finnff/mrb2021/img/2023-08-11-15-56-42.png

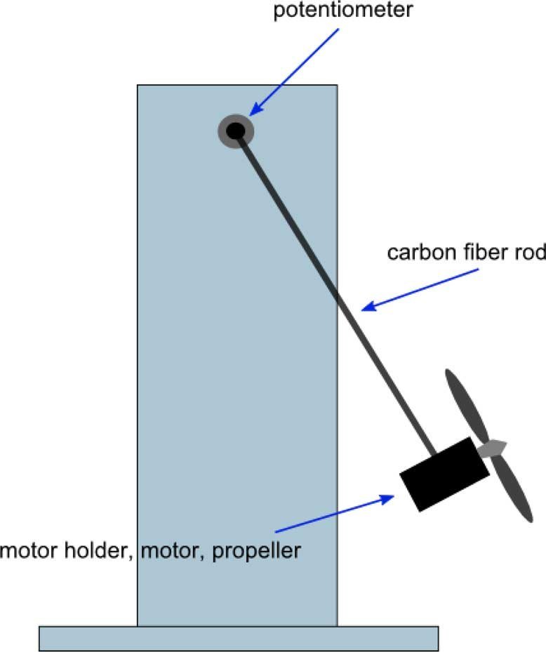
img/2023-08-11-15-56-42.png
