finnff/mrb2021/img/2023-08-28-07-30-38.png

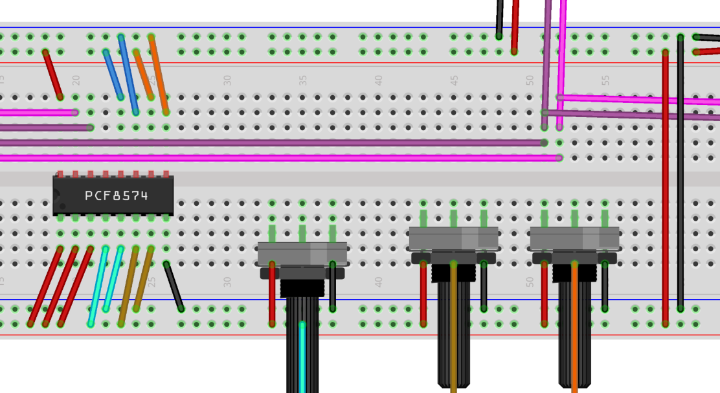
img/2023-08-28-07-30-38.png
