finnff/mrb2021/img/2023-08-28-08-42-56.png

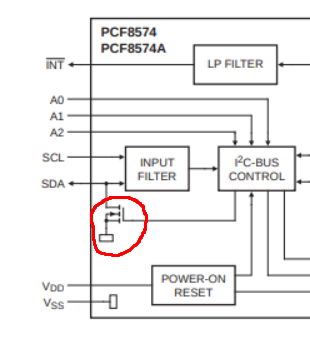
img/2023-08-28-08-42-56.png
