finnff/mrb2021/img/2023-08-28-09-48-56.png

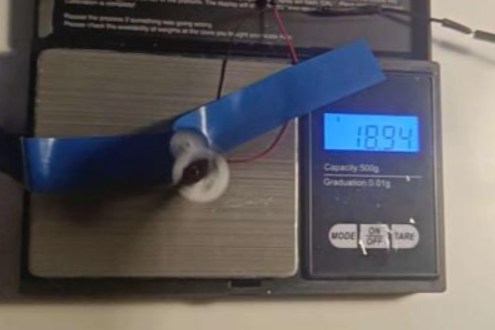
img/2023-08-28-09-48-56.png
