finnff/mrb2021/img/IMG_MRB_1643.jpg

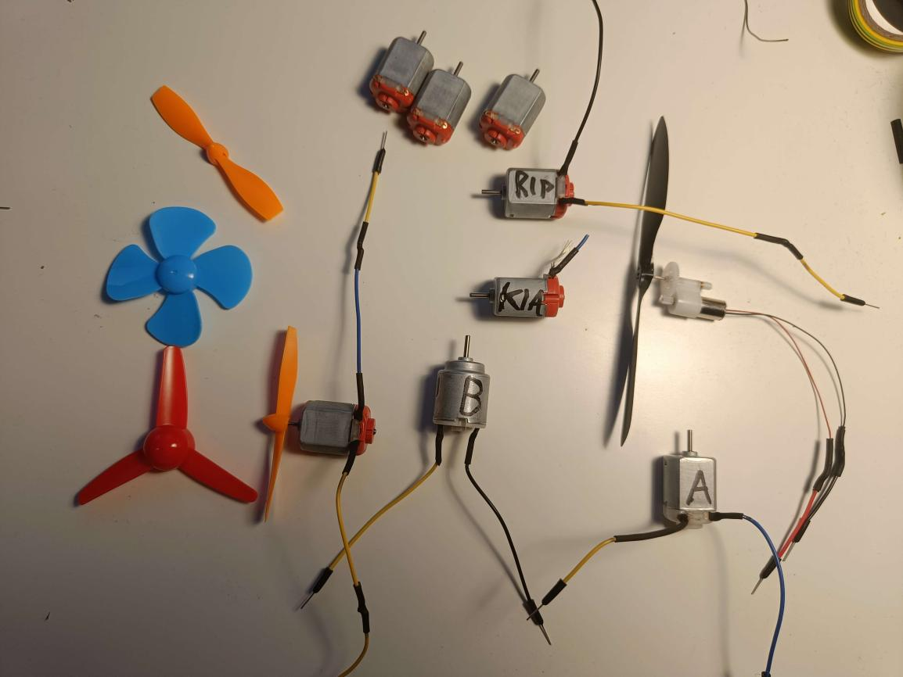
img/IMG_MRB_1643.jpg
