finnff/mrb2021/img/IMG_MRB_2103.jpg

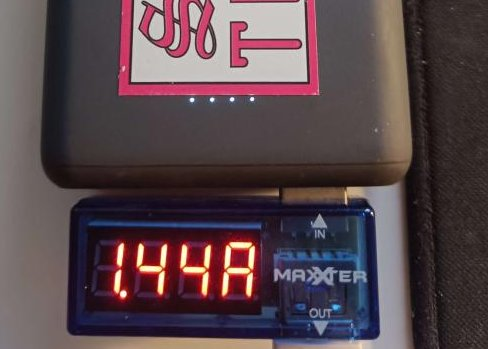
img/IMG_MRB_2103.jpg
