finnff/mrb2021/img/IMG_MRB_2346.jpg

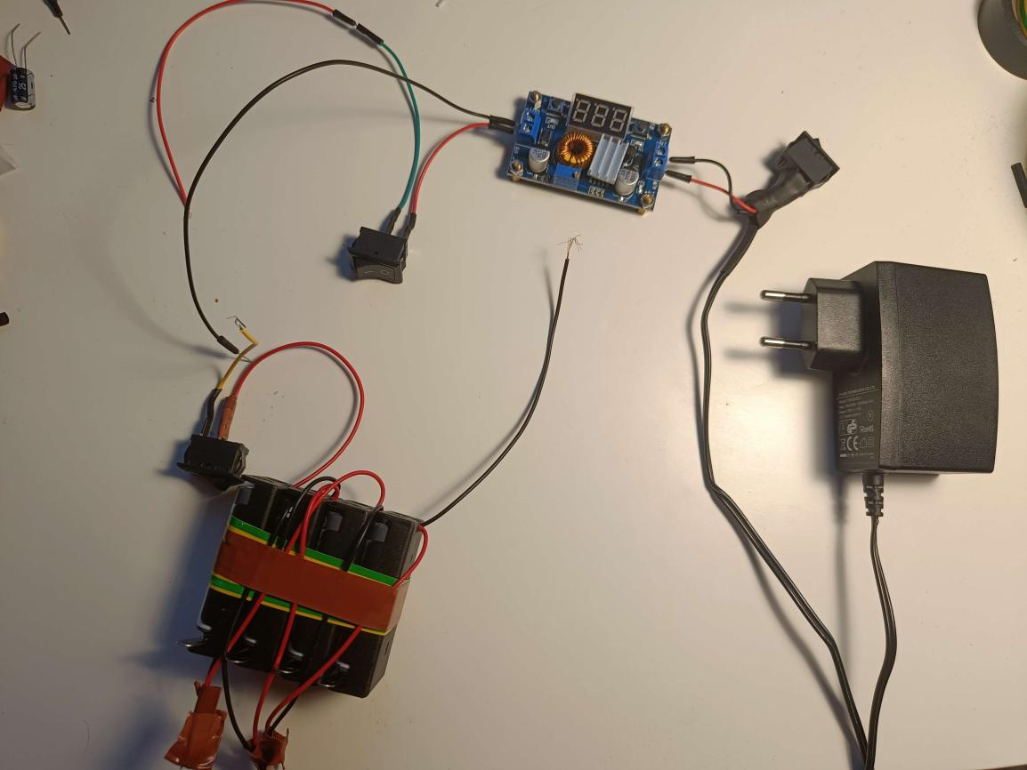
img/IMG_MRB_2346.jpg
