finnff/mrb2021/img/IMG_MRB_2454.jpg

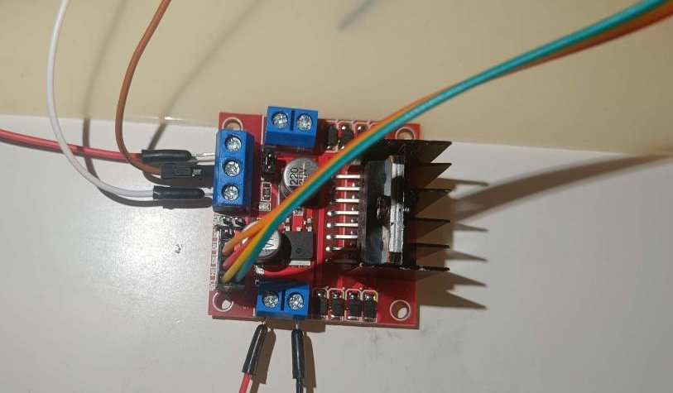
img/IMG_MRB_2454.jpg
