finnff/mrb2021/img/IMG_MRB_2641.jpg

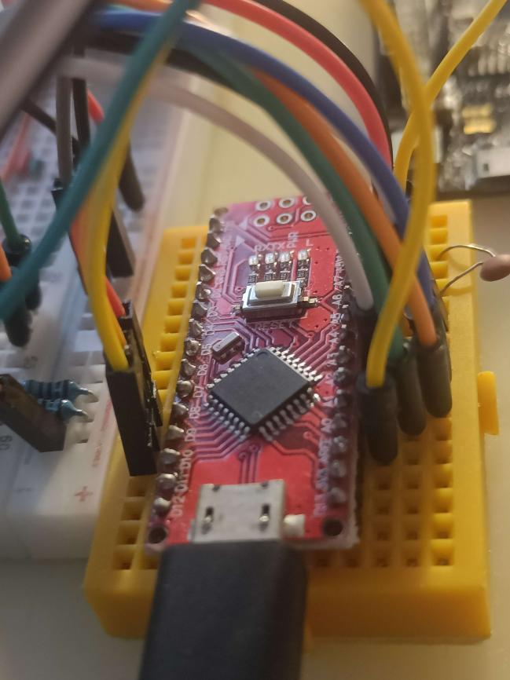
img/IMG_MRB_2641.jpg
