finnff/mrb2021/img/IMG_MRB_2737.jpg

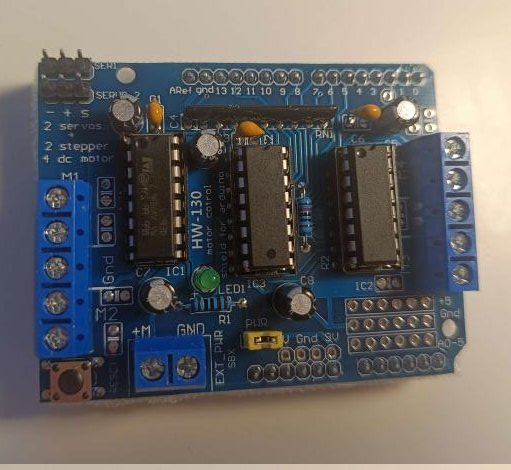
img/IMG_MRB_2737.jpg
