finnff/mrb2021/img/IMG_MRB_2856.jpg

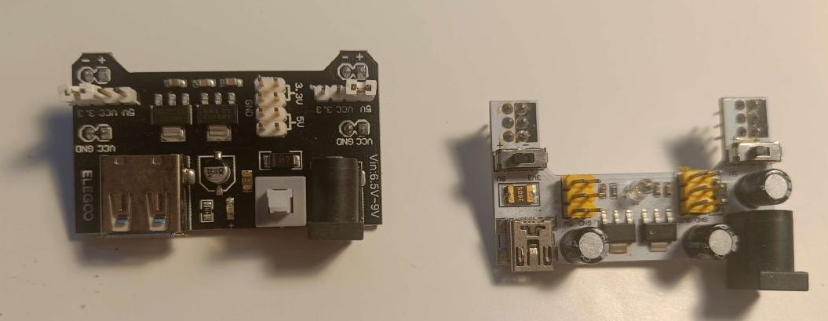
img/IMG_MRB_2856.jpg
