finnff/mrb2021/img/IMG_MRB_2940.jpg

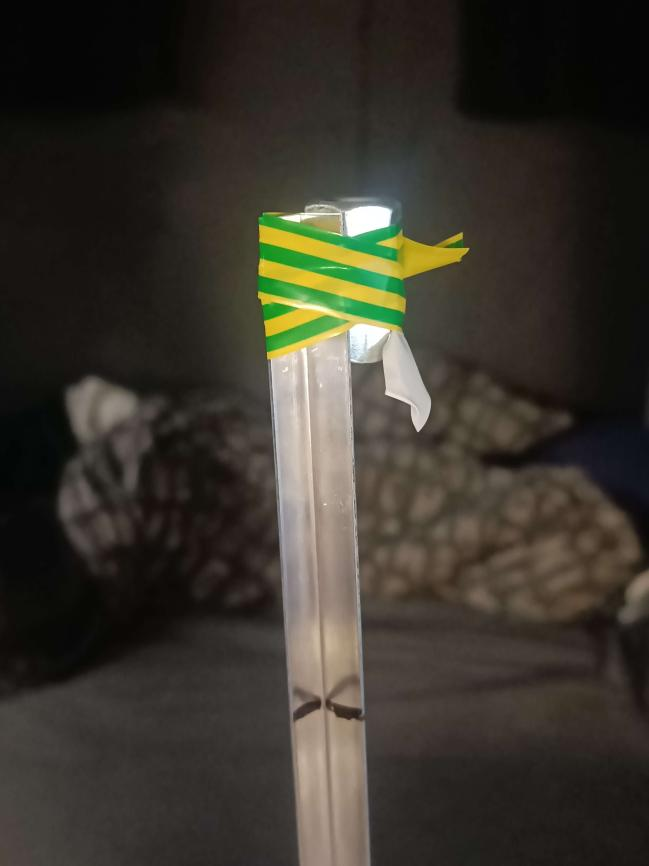
img/IMG_MRB_2940.jpg
