finnff/mrb2021/img/IMG_MRB_3024.jpg

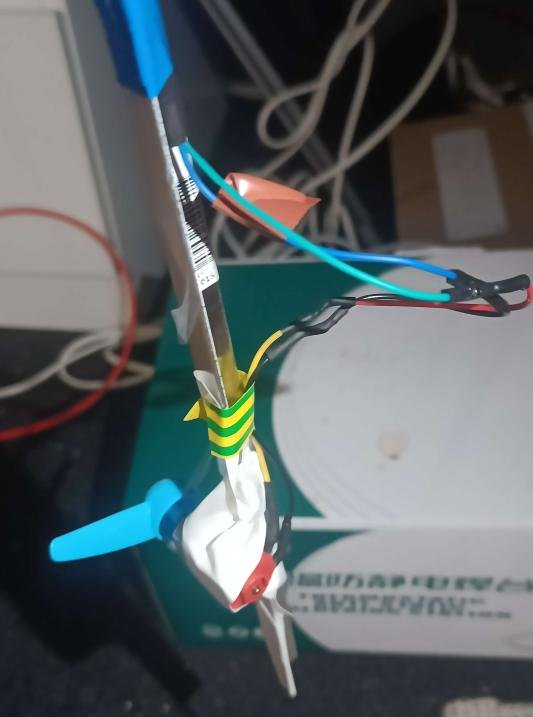
img/IMG_MRB_3024.jpg
