finnff/mrb2021/img/IMG_MRB_3030.jpg

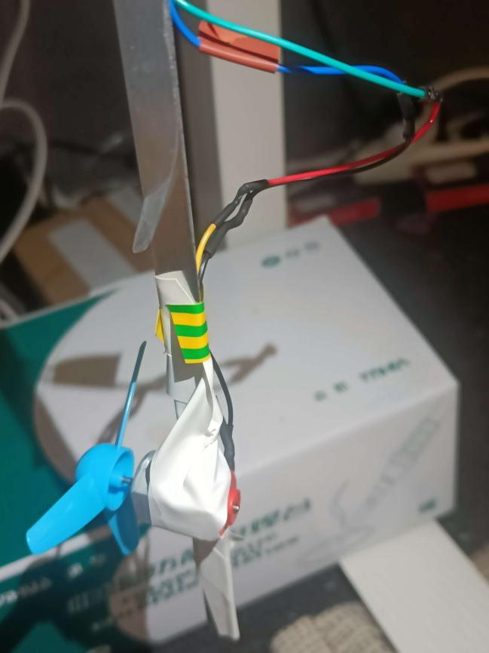
img/IMG_MRB_3030.jpg
