finnff/mrb2021/img/IMG_MRB_3045.jpg

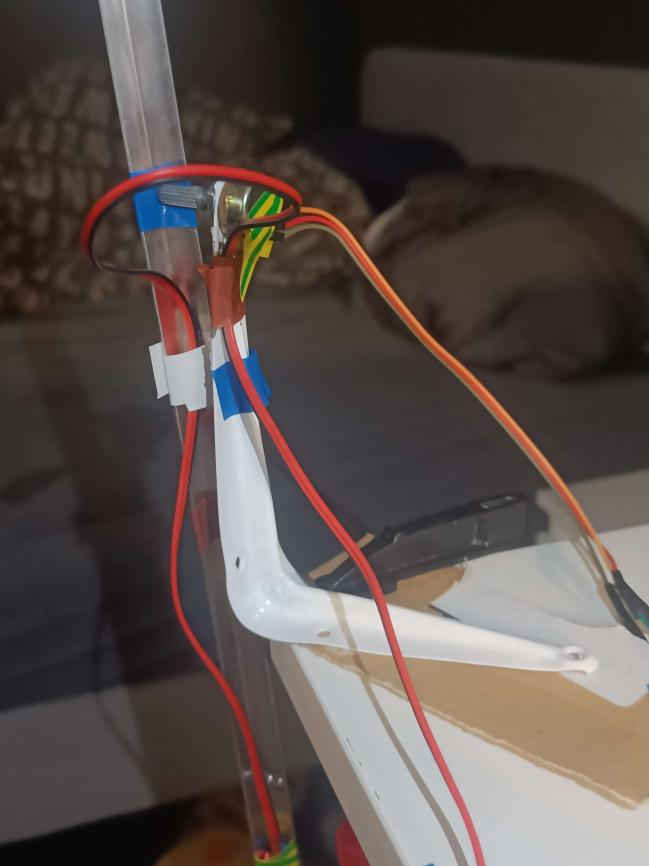
img/IMG_MRB_3045.jpg
