finnff/mrb2021/img/IMG_MRB_3117.jpg

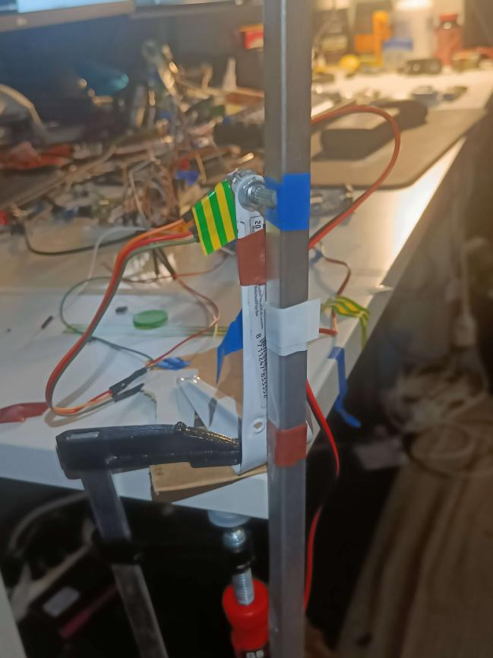
img/IMG_MRB_3117.jpg
