finnff/mrb2021/img/IMG_MRB_3235.jpg

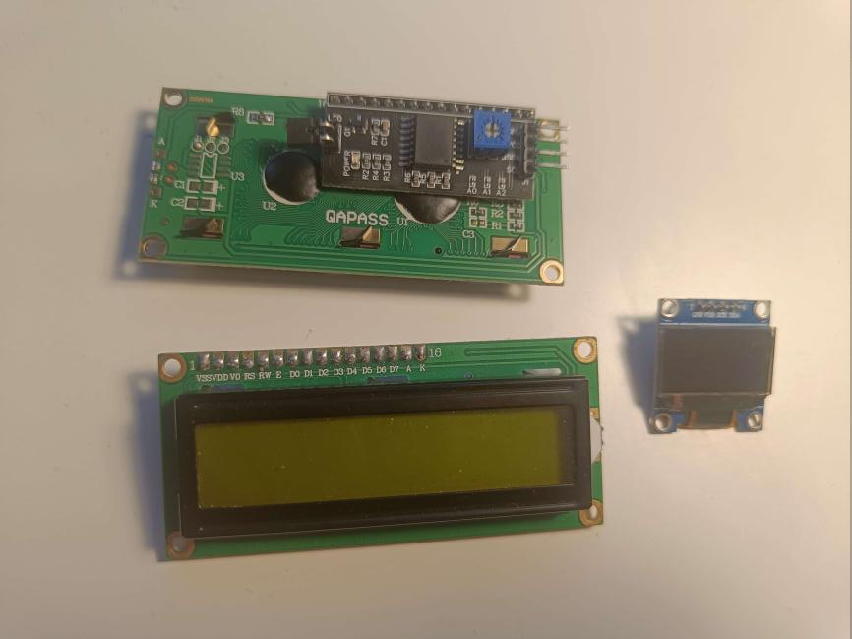
img/IMG_MRB_3235.jpg
