finnff/mrb2021/img/IMG_MRB_3644.jpg

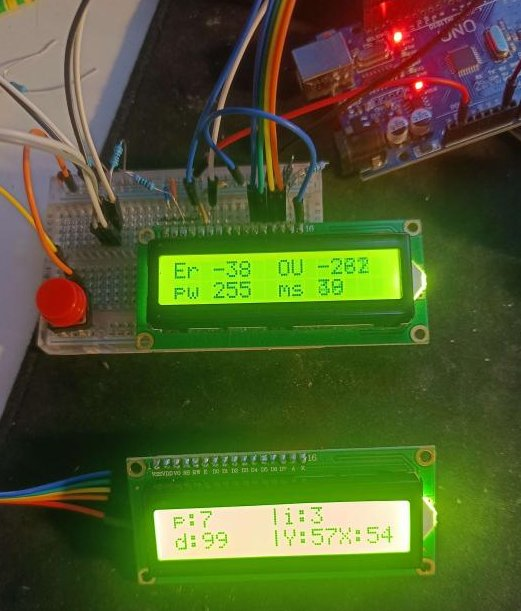
img/IMG_MRB_3644.jpg
