finnff/mrb2021/img/IMG_MRB_3653.jpg

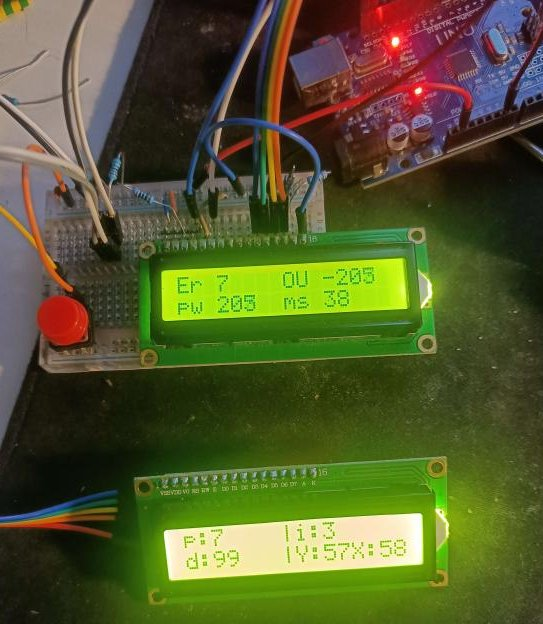
img/IMG_MRB_3653.jpg
