finnff/mrb2021/img/IMG_MRB_3918.jpg

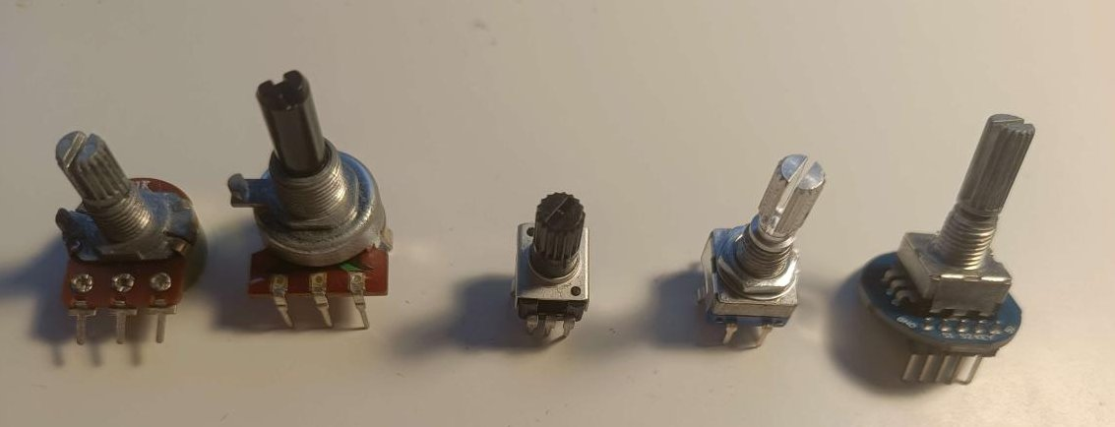
img/IMG_MRB_3918.jpg
