finnff/mrb2021/img/IMG_MRB_3999.jpg

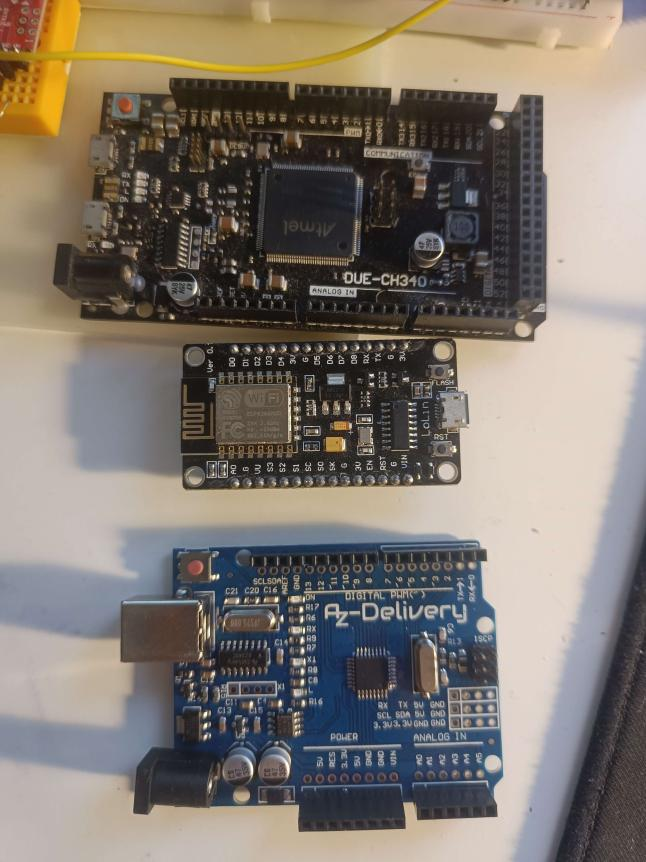
img/IMG_MRB_3999.jpg
