finnff/mrb2021/TPD_files/figure-latex/figure_APmain-1.pdf

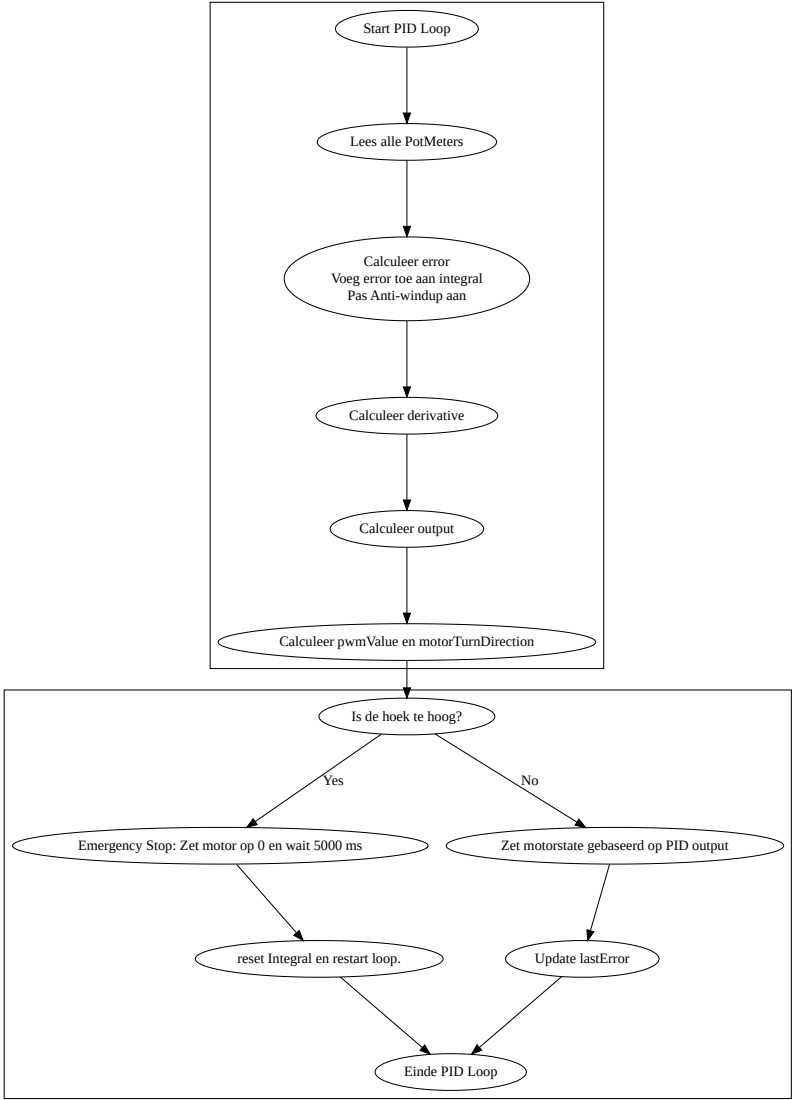
[picture p28: page 1]
Calculeer derivative; Calculeer output; Yes; Update lastError

Start PID Loop

Lees alle PotMeters

Calculeer error
Voeg error toe aan integral
Pas Anti-windup aan

Calculeer pwmValue en motorTurnDirection

Is de hoek te hoog?

Emergency Stop: Zet motor op 0 en wait 5000 ms

Zet motorstate gebaseerd op PID output

reset Integral en restart loop.

Einde PID Loop
