finnff/mrb2021/TPD_files/figure-latex/figure_main-1.pdf

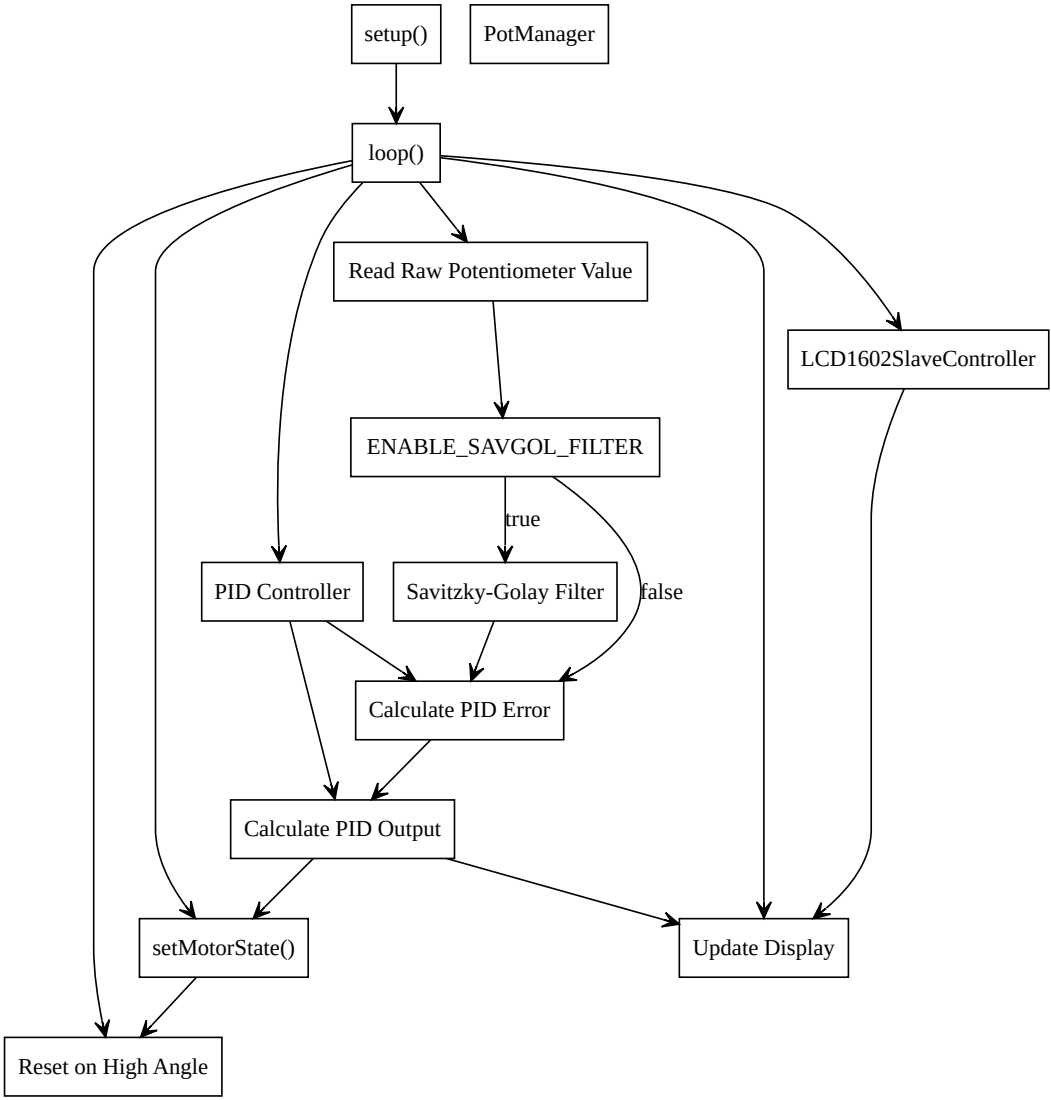
[picture p29: page 1]
setup(); loop(); PID Controller; LCD1602SlaveController; setMotorState(); Update Display; PotManager; ENABLE_SAVGOL_FILTER; true; false

Read Raw Potentiometer Value

Savitzky-Golay Filter

Calculate PID Error

Calculate PID Output

Reset on High Angle
