finnff/mrb2021/TPD_files/figure-latex/figure_ontwerp-1.pdf

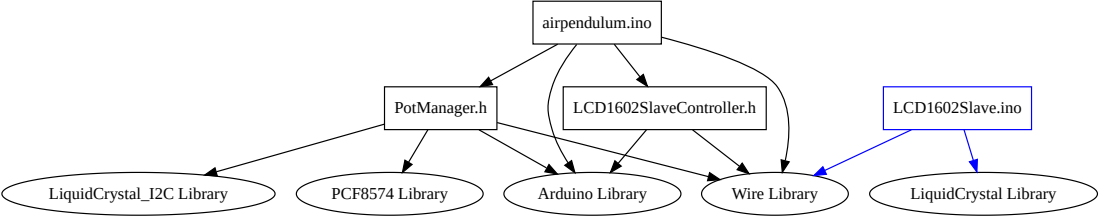
[picture p30: page 1]
airpendulum.ino; PotManager.h; LCD1602SlaveController.h; LiquidCrystal_I2C Library; PCF8574 Library; Arduino Library; Wire Library; LCD1602Slave.ino; LiquidCrystal Library
