finnff/mrb2021/TPD_files/figure-latex/figure_z45-1.pdf

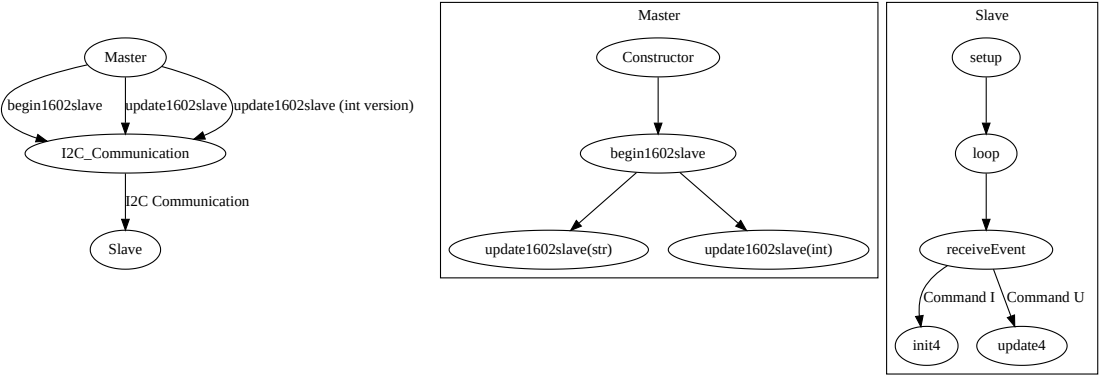
[picture p31: page 1]
Master; Slave; I2C_Communication; begin1602slave; update1602slave update1602slave (int version); I2C Communication; Constructor; update1602slave(str); update1602slave(int); setup; loop; receiveEvent; init4; Command I; update4; Command U
