finnff/mrb2021/TPD_files/figure-latex/figure_savgolay-1.pdf

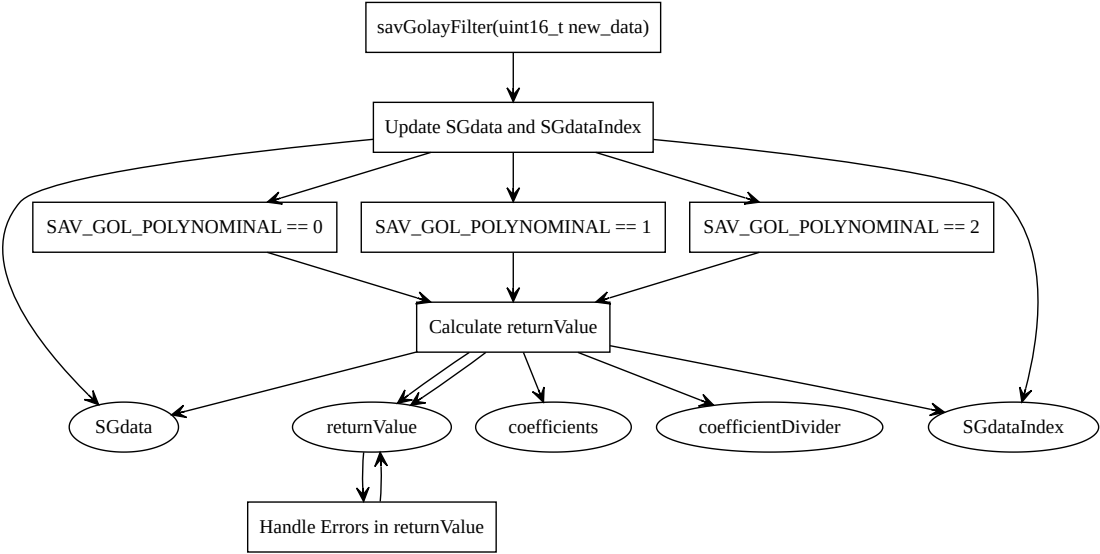
[picture p32: page 1]
savGolayFilter(uint16_t new_data); SGdata; returnValue; SGdataIndex; coefficients; coefficientDivider; SAV_GOL_POLYNOMINAL == 0; Calculate returnValue; SAV_GOL_POLYNOMINAL == 1; SAV_GOL_POLYNOMINAL == 2

Update SGdata and SGdataIndex

Handle Errors in returnValue
