finnff/mrb2021/(list of files, drawings)

Other design files:
fritzling/mrb23.fzz
